ryantay8921/ESP32-DevBoard/jlcpcb/production_files/SMT026041460213-12296012A+X-ray+Inspection+Report/12296012A-Y9/2.jpg

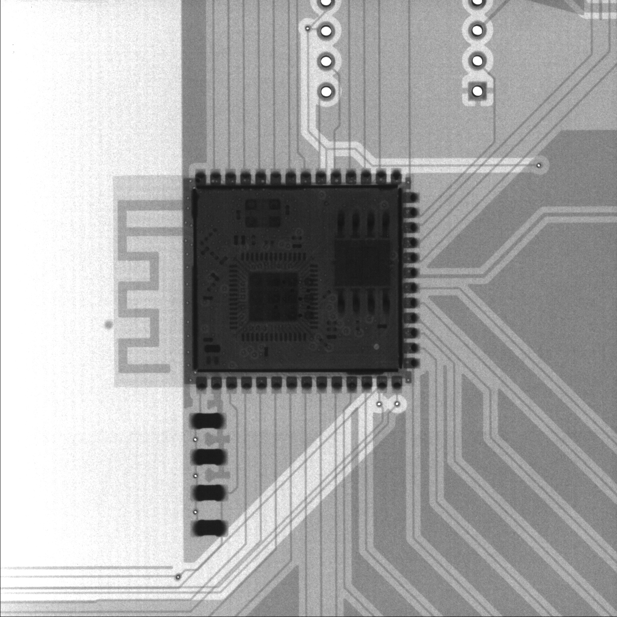
jlcpcb/production_files/SMT026041460213-12296012A+X-ray+Inspection+Report/12296012A-Y9/2.jpg
