ryantay8921/ESP32-DevBoard/(list of files, drawings)

Other design files:
freerouting.dsn
Libraries_person/New folder/HYCW403-USBC16-785B1_HYCW403-USBC16-785B.schdoc
Libraries_person/New folder/USB-C-SMD_HYCW403-USBC16-785B (1).pcbdoc
temp-freerouting.dsn
