ryantay8921/ESP32-DevBoard/V67_cycletron.kicad_pcb

## KiCad design V67_cycletron.kicad_pcb (2026-04-27)

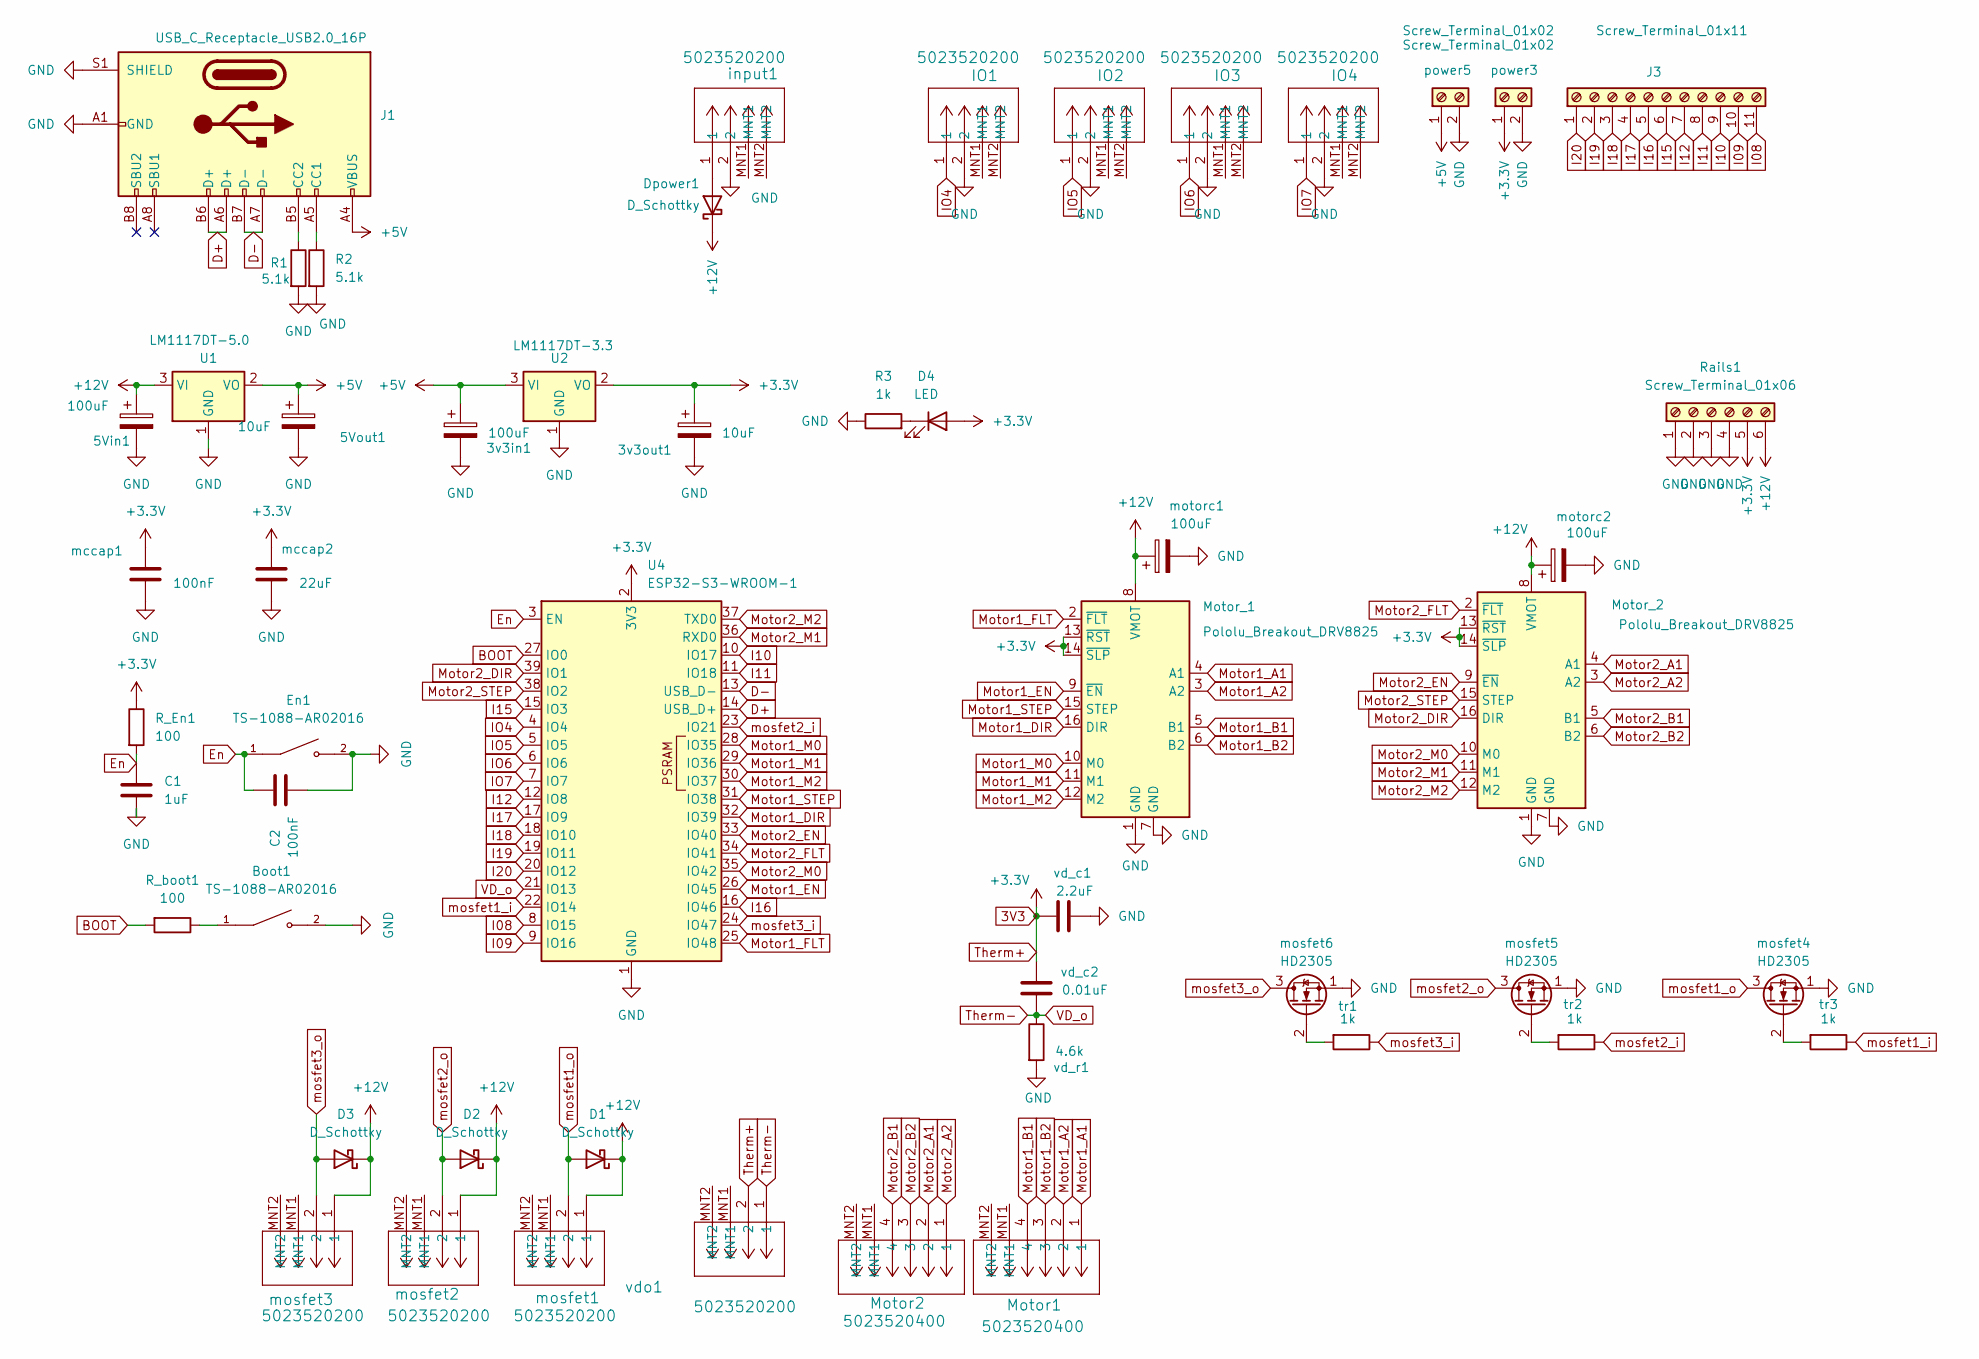
[picture p3: schematic V67_cycletron.kicad_sch]

Parts:
3v3in1, 5Vin1: 100uF; CP_Elec_6.3x5.4; LCSC C7469933
3v3out1, 5Vout1: 10uF; CP_Elec_4x5.4; LCSC C3343
Boot1: TS-1088-AR02016; SW_TS-1088-AR02016; PARTREV N/A; LCSC C720477
C1: 1uF; C_0805_2012Metric_Pad1.18x1.45mm_HandSolder; LCSC C28323
C2: 100nF; C_0805_2012Metric_Pad1.18x1.45mm_HandSolder; LCSC C28233
D1, D2, D3: D_Schottky; D_SMA; LCSC C22452
D4: LED; LED_0603_1608Metric_Pad1.05x0.95mm_HandSolder; LCSC C125099
Dpower1: D_Schottky; D_SMA; LCSC C22452
En1: TS-1088-AR02016; SW_TS-1088-AR02016; PARTREV N/A; LCSC C720477
IO1, IO2, IO3, IO4: 5023520200; CONN_SD-502352-001_02_MOL; LCSC C114107
J1: USB_C_Receptacle_USB2.0_16P; USB_C_Receptacle_HRO_TYPE-C-31-M-12; LCSC C5338271
J3: Screw_Terminal_01x11; TerminalBlock_MaiXu_MX126-5.0-11P_1x11_P5.00mm
Motor1, Motor2: 5023520400; CONN_SD-502352-001_04_MOL; LCSC C277598
Motor_1, Motor_2: Pololu_Breakout_DRV8825; Pololu_Breakout-16_15.2x20.3mm; LCSC C46061772
R1, R2: 5.1k; R_0805_2012Metric_Pad1.20x1.40mm_HandSolder; LCSC C27834
R3: 1k; R_0805_2012Metric_Pad1.20x1.40mm_HandSolder
R_En1: 100; R_0805_2012Metric_Pad1.20x1.40mm_HandSolder; LCSC C17408
R_boot1: 100; R_0805_2012Metric_Pad1.20x1.40mm_HandSolder; LCSC C17408
Rails1: Screw_Terminal_01x06; TerminalBlock_MaiXu_MX126-5.0-06P_1x06_P5.00mm
U1: LM1117DT-5.0; TO-252-3_TabPin2; LCSC C354068
U2: LM1117DT-3.3; TO-252-3_TabPin2; LCSC C969102
U4: ESP32-S3-WROOM-1
input1: 5023520200; CONN_SD-502352-001_02_MOL; LCSC C114107
mccap1: 100nF; C_0805_2012Metric_Pad1.18x1.45mm_HandSolder
mccap2: 22uF; C_0805_2012Metric_Pad1.18x1.45mm_HandSolder
mosfet1, mosfet2, mosfet3: 5023520200; CONN_SD-502352-001_02_MOL; LCSC C114107
mosfet4, mosfet5, mosfet6: HD2305; SOT-23; LCSC C466664
motorc1, motorc2: 100uF; CP_Elec_6.3x5.4; LCSC C2749
power3, power5: Screw_Terminal_01x02; TerminalBlock_MaiXu_MX126-5.0-02P_1x02_P5.00mm; LCSC C5188434
tr1, tr2, tr3: 1k; R_0805_2012Metric_Pad1.20x1.40mm_HandSolder; LCSC C17513
vd_c1: 2.2uF; C_0805_2012Metric_Pad1.18x1.45mm_HandSolder; LCSC C377773
vd_c2: 0.01uF; C_0805_2012Metric_Pad1.18x1.45mm_HandSolder; LCSC C1710
vd_r1: 4.6k; R_Axial_DIN0207_L6.3mm_D2.5mm_P7.62mm_Horizontal
vdo1: 5023520200; CONN_SD-502352-001_02_MOL; LCSC C114107

Connections:
3V3: 3v3out1.1, D4.2 (A), Motor_1.13 (~RST), Motor_1.14 (~SLP), Motor_2.13 (~RST), Motor_2.14 (~SLP), R_En1.1, Rails1.5, U2.2 (VO), U4.2 (3V3), mccap1.1, mccap2.1, power3.1, vd_c1.1, vd_c2.2, vdo1.2
+5V: 3v3in1.1, 5Vout1.1, J1.A4 (VBUS), J1.A9 (VBUS), J1.B4 (VBUS), J1.B9 (VBUS), U1.2 (VO), U2.3 (VI), power5.1
+12V: 5Vin1.1, D1.1 (K), D2.1 (K), D3.1 (K), Dpower1.1 (K), Motor_1.8 (VMOT), Motor_2.8 (VMOT), Rails1.6, U1.3 (VI), mosfet1.1, mosfet2.1, mosfet3.1, motorc1.1, motorc2.1
BOOT: R_boot1.2, U4.27 (IO0)
D+: J1.A6 (D+), J1.B6 (D+), U4.14 (USB_D+)
D-: J1.A7 (D-), J1.B7 (D-), U4.13 (USB_D-)
En: C1.1, C2.1, En1.1, R_En1.2, U4.3 (EN)
GND: 3v3in1.2, 3v3out1.2, 5Vin1.2, 5Vout1.2, Boot1.2, C1.2, C2.2, En1.2, IO1.2, IO2.2, IO3.2, IO4.2, J1.A1 (GND), J1.A12 (GND), J1.B1 (GND), J1.B12 (GND), J1.S1 (SHIELD), Motor_1.1 (GND), Motor_1.7 (GND), Motor_2.1 (GND), Motor_2.7 (GND), R1.2, R2.2, R3.1, Rails1.1, Rails1.2, Rails1.3, Rails1.4, U1.1 (GND), U2.1 (GND), U4.1 (GND), U4.40 (GND), U4.41 (GND), input1.2, mccap1.2, mccap2.2, mosfet4.1 (S), mosfet5.1 (S), mosfet6.1 (S), motorc1.2, motorc2.2, power3.2, power5.2, vd_c1.2, vd_r1.2
I08: J3.11, U4.8 (IO15)
I09: J3.10, U4.9 (IO16)
I10: J3.9, U4.10 (IO17)
I11: J3.8, U4.11 (IO18)
I12: J3.7, U4.12 (IO8)
I15: J3.6, U4.15 (IO3)
I16: J3.5, U4.16 (IO46)
I17: J3.4, U4.17 (IO9)
I18: J3.3, U4.18 (IO10)
I19: J3.2, U4.19 (IO11)
I20: J3.1, U4.20 (IO12)
IO4: IO1.1, U4.4 (IO4)
IO5: IO2.1, U4.5 (IO5)
IO6: IO3.1, U4.6 (IO6)
IO7: IO4.1, U4.7 (IO7)
Motor1_A1: Motor1.1, Motor_1.4 (A1)
Motor1_A2: Motor1.2, Motor_1.3 (A2)
Motor1_B1: Motor1.4, Motor_1.5 (B1)
Motor1_B2: Motor1.3, Motor_1.6 (B2)
Motor1_DIR: Motor_1.16 (DIR), U4.32 (IO39)
Motor1_EN: Motor_1.9 (~EN), U4.26 (IO45)
Motor1_FLT: Motor_1.2 (~FLT), U4.25 (IO48)
Motor1_M0: Motor_1.10 (M0), U4.28 (IO35)
Motor1_M1: Motor_1.11 (M1), U4.29 (IO36)
Motor1_M2: Motor_1.12 (M2), U4.30 (IO37)
Motor1_STEP: Motor_1.15 (STEP), U4.31 (IO38)
Motor2_A1: Motor2.2, Motor_2.4 (A1)
Motor2_A2: Motor2.1, Motor_2.3 (A2)
Motor2_B1: Motor2.4, Motor_2.5 (B1)
Motor2_B2: Motor2.3, Motor_2.6 (B2)
Motor2_DIR: Motor_2.16 (DIR), U4.39 (IO1)
Motor2_EN: Motor_2.9 (~EN), U4.33 (IO40)
Motor2_FLT: Motor_2.2 (~FLT), U4.34 (IO41)
Motor2_M0: Motor_2.10 (M0), U4.35 (IO42)
Motor2_M1: Motor_2.11 (M1), U4.36 (RXD0)
Motor2_M2: Motor_2.12 (M2), U4.37 (TXD0)
Motor2_STEP: Motor_2.15 (STEP), U4.38 (IO2)
unnamed: Boot1.1, R_boot1.1
unnamed: D4.1 (K), R3.2
unnamed: Dpower1.2 (A), input1.1
unnamed: J1.A5 (CC1), R2.1
unnamed: J1.B5 (CC2), R1.1
unnamed: mosfet4.2 (G), tr3.2
unnamed: mosfet5.2 (G), tr2.2
unnamed: mosfet6.2 (G), tr1.2
Therm-: U4.21 (IO13), vd_c2.1, vd_r1.1, vdo1.1
mosfet1_i: U4.22 (IO14), tr3.1
mosfet1_o: D1.2 (A), mosfet1.2, mosfet4.3 (D)
mosfet2_i: U4.23 (IO21), tr2.1
mosfet2_o: D2.2 (A), mosfet2.2, mosfet5.3 (D)
mosfet3_i: U4.24 (IO47), tr1.1
mosfet3_o: D3.2 (A), mosfet3.2, mosfet6.3 (D)

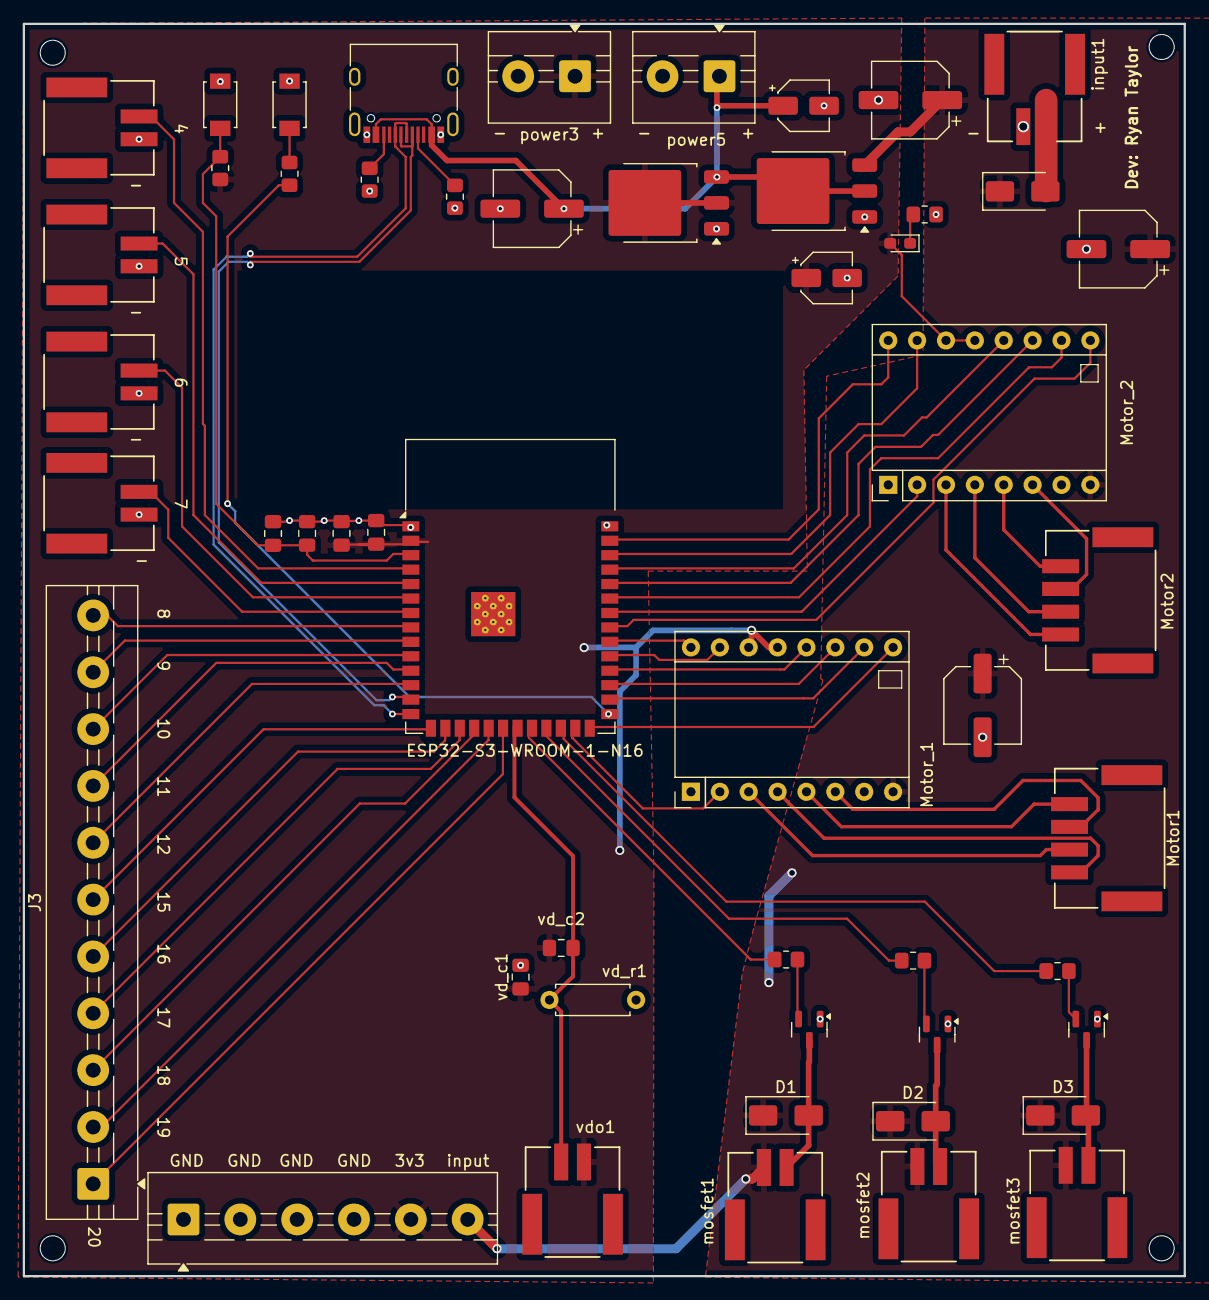
[picture p4: board V67_cycletron.kicad_pcb from above]

Board: 2 copper layers, 102.1 x 110.1 mm, 52 parts (0 on the bottom side), 60 nets.
