ryantay8921/ESP32-DevBoard/(commit log)

2026-04-06 first commit of board
    [BOM-V67_cycletron.csv, HYCW403-USBC16-785B1_HYCW403-USBC16-785B.schdoc, USB-C-SMD_HYCW403-USBC16-785B (1).pcbdoc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]
2026-04-06 test commit, added schotsky diode
    [V67_cycletron.kicad_pcb, V67_cycletron.kicad_sch]
2026-04-07 got all parts to sync to jlcpcb
    [BOM-V67_cycletron.csv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]
2026-04-07 moved IO
    [V67_cycletron-CuBottom.gbr, V67_cycletron-CuTop.gbr, V67_cycletron-EdgeCuts.gbr, V67_cycletron-MaskBottom.gbr, V67_cycletron-MaskTop.gbr, V67_cycletron-NPTH.drl, V67_cycletron-PTH.drl, V67_cycletron-PasteBottom.gbr]
2026-04-07 fixed some issues with vias and motor connector placement
    [V67_cycletron-CuBottom.gbr, V67_cycletron-CuTop.gbr, V67_cycletron-EdgeCuts.gbr, V67_cycletron-MaskBottom.gbr, V67_cycletron-MaskTop.gbr, V67_cycletron-NPTH.drl, V67_cycletron-PTH.drl, V67_cycletron-PasteBottom.gbr]
2026-04-10 changed some stuff
    [V67_cycletron.kicad_pcb, V67_cycletron.kicad_sch]
2026-04-10 changed some stuff 2
    [V67_cycletron.kicad_pcb, V67_cycletron.kicad_sch]
2026-04-10 changed some stuff 3
    [V67_cycletron.kicad_pcb]
2026-04-10 changed mosfets added more terminals
    [BOM-V67_cycletron.csv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]
2026-04-12 fixed drc, added silscreen notes, made certain vias bigger
    [V67_cycletron.kicad_pcb, V67_cycletron.kicad_sch]
2026-04-14 purchased boards
    [BOM-V67_cycletron.csv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]
2026-04-23 Push verified PCB
    [BOM-V67_cycletron.csv, HYCW403-USBC16-785B1_HYCW403-USBC16-785B.schdoc, USB-C-SMD_HYCW403-USBC16-785B (1).pcbdoc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]
2026-04-27 edited silkscreen
    [V67_cycletron.kicad_pcb, V67_cycletron.kicad_sch]
2026-05-03 created pin mapping xlsx and test script
    [ESP32_pin_mapping.xlsx]
